UNIMOC-Universal-Motor-Control/hardware_4850/logic/datasheets/pas torque sensor.webp

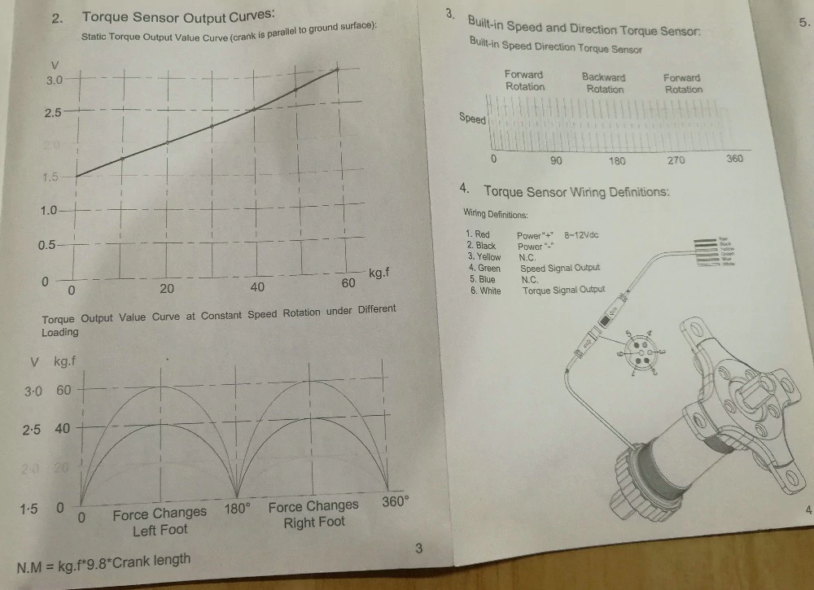
logic/datasheets/pas torque sensor.webp
