UNIMOC-Universal-Motor-Control/hardware_4850/logic/mcu_pinning.jpg

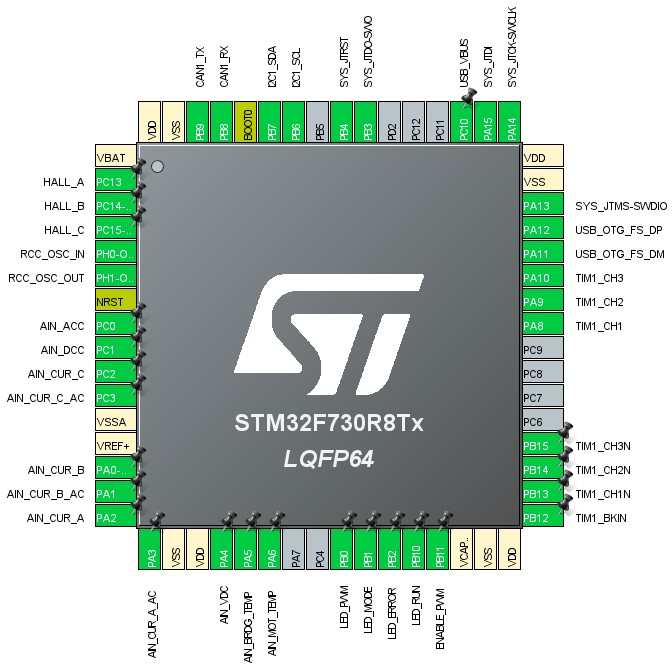
logic/mcu_pinning.jpg
