UNIMOC-Universal-Motor-Control/hardware_4850/README.md

# hardware_4850
48V at 50A with optimised colling
