UNIMOC-Universal-Motor-Control/hardware_4850/logic/sim/filter-design-current.pdf

## Filter Design Report

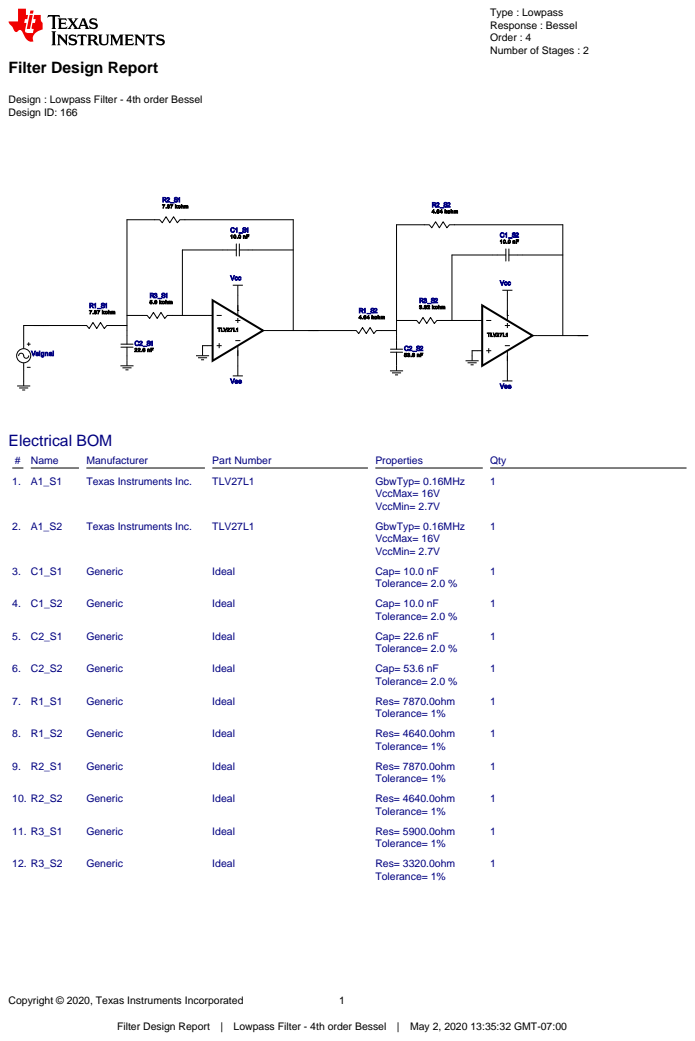
[picture p3: page 1]
Copyright © 2020, Texas Instruments Incorporated; Vsignal; TLV27L1; R1_S1 7.87 kohm; R2_S1 7.87 kohm; R3_S1 5.9 kohm; Vcc; Vee; R1_S2 4.64 kohm; R2_S2 4.64 kohm; R3_S2 3.32 kohm; Electrical BOM; # Name; Manufacturer; Part Number; Properties; Qty; Texas Instruments Inc.; GbwTyp= 0.16MHz; VccMax= 16V VccMin= 2.7V; Generic; Ideal; Cap= 10.0 nF; Tolerance= 2.0 %; Cap= 22.6 nF; Cap= 53.6 nF; Res= 7870.0ohm; Tolerance= 1%; Res= 4640.0ohm; Res= 5900.0ohm; Res= 3320.0ohm

Type : Lowpass
Response : Bessel
Order : 4
Number of Stages : 2

Design : Lowpass Filter - 4th order Bessel
Design ID: 166

Filter Design Report | Lowpass Filter - 4th order Bessel | May 2, 2020 13:35:32 GMT-07:00

## Sensitivity Analysis

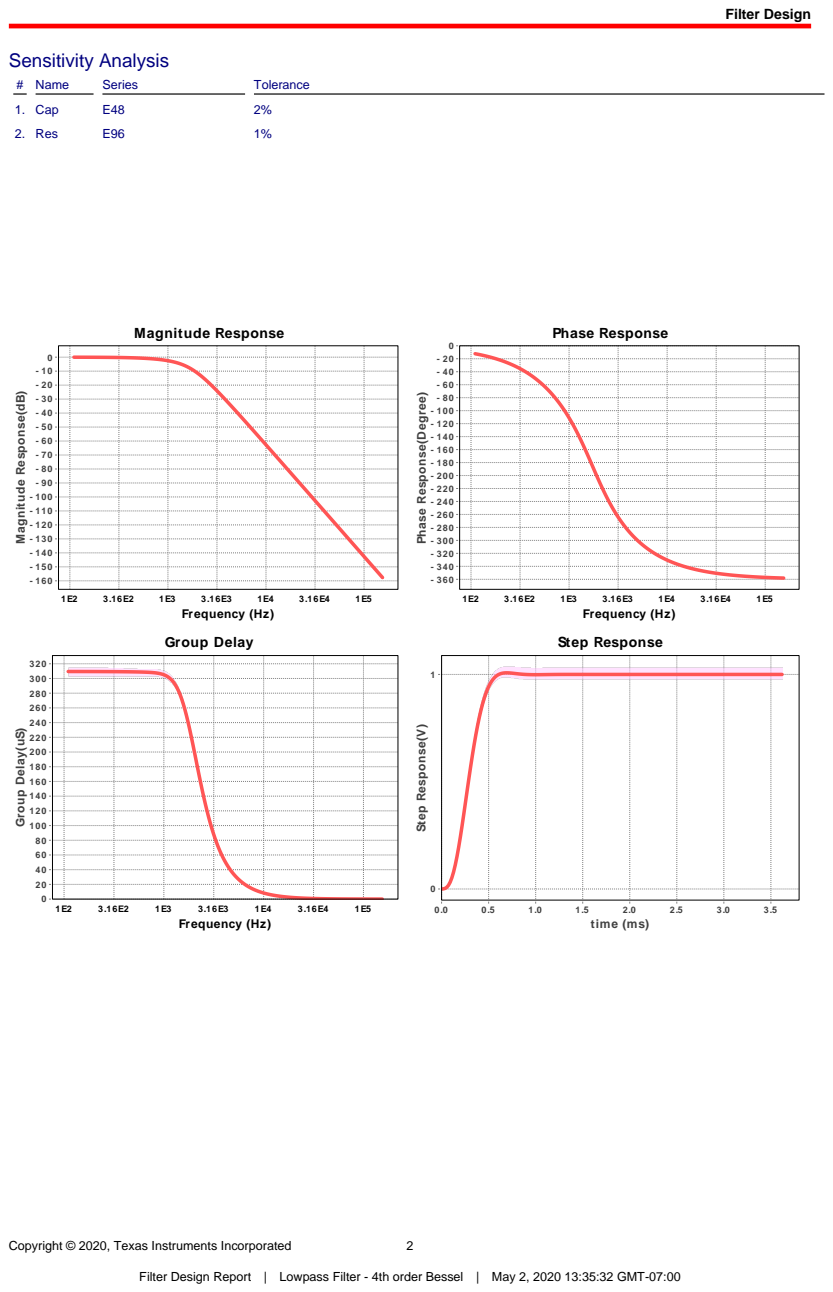
[picture p4: page 2]
Filter Design; # Name; Series; Tolerance; 1. Cap; 2. Res; Magnitude Response; 1E5 Frequency (Hz); Phase Response; Group Delay; Step Response; time (ms); 1Step Response⁽V⁾

Magnitude Response(dB)

Phase Response(Degree)

Group Delay(uS)

## Design Inputs

# | Name | Value | Description

1. FilterType | lowpass
2. FilterResponse | Bessel
3. FilterOrder | 4.0
4. FilterTopology | Multiple Feedback
5. NumberOfStages | 2.0
6. PassbandFrequency | 1.1 k
7. StopbandAttenuation | -78.912
8. StopbandFrequency | 16.0 k
9. Gain | 1.0
10. DualSupply | +/-5.00 V | Power supply(s) to active chips
11. ResistorTolerance | E96 | Resistor series - 1% Passive resistor tolerance
12. CapacitorTolerance | E48 | Capacitor series - 2% Passive capacitor tolerance

## Design Assistance

1. TLV27L1 Product Folder : http://www.ti.com/product/TLV27L1 : contains the data sheet and other resources.

# Filter Stage :1

Cutoff Frequency | 1.554 kHz
Min GBW Reqd | 81.482 kHz
Stage Gain | 1.0 V/V
Stage Q | 520.791 m
Stage Topology | Multiple Feedback
| R2_S1 7.87 kohm

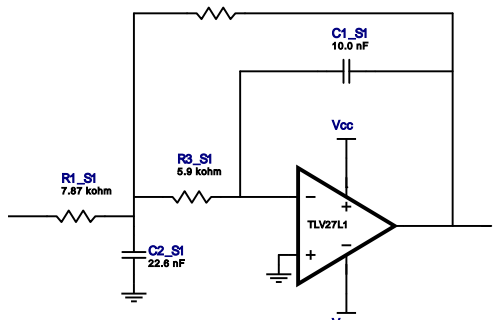
[picture p5: figure]
TLV27L1; R1_S1 7.87 kohm; R3_S1 5.9 kohm; Vcc

Vee

## Electrical BOM

# Name | Manufacturer | Part Number | Properties | Qty

1. A1_S1 | Texas Instruments Inc. | TLV27L1 | GbwTyp= 0.16MHz VccMax= 16V VccMin= 2.7V | 1
2. C1_S1 | Generic | Ideal | Cap= 10.0 nF Tolerance= 2.0 %

1

3. C2_S1 | Generic | Ideal | Cap= 22.6 nF Tolerance= 2.0 %

1

4. R1_S1 | Generic | Ideal | Res= 7870.0ohm Tolerance= 1%

1

5. R2_S1 | Generic | Ideal | Res= 7870.0ohm Tolerance= 1%

1

6. R3_S1 | Generic | Ideal | Res= 5900.0ohm Tolerance= 1%

1

# Filter Stage :2

Cutoff Frequency | 1.751 kHz
Min GBW Reqd | 140.997 kHz
Stage Gain | 1.0 V/V
Stage Q | 805.566 m
Stage Topology | Multiple Feedback
| R2_S2 4.64 kohm

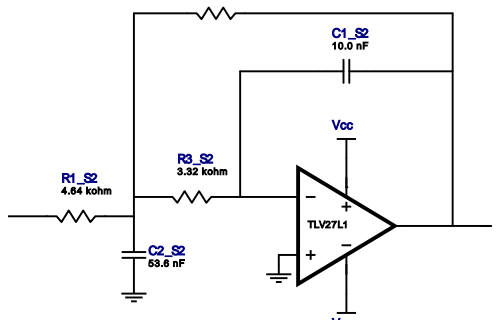
[picture p6: figure]
TLV27L1; R1_S2 4.64 kohm; R3_S2 3.32 kohm; Vcc

Vee

## Electrical BOM

# Name | Manufacturer | Part Number | Properties | Qty

1. A1_S2 | Texas Instruments Inc. | TLV27L1 | GbwTyp= 0.16MHz VccMax= 16V VccMin= 2.7V | 1
2. C1_S2 | Generic | Ideal | Cap= 10.0 nF Tolerance= 2.0 %

1

3. C2_S2 | Generic | Ideal | Cap= 53.6 nF Tolerance= 2.0 %

1

4. R1_S2 | Generic | Ideal | Res= 4640.0ohm Tolerance= 1%

1

5. R2_S2 | Generic | Ideal | Res= 4640.0ohm Tolerance= 1%

1

6. R3_S2 | Generic | Ideal | Res= 3320.0ohm Tolerance= 1%

1

Important Notice and Disclaimer

TI provides technical and reliability data (including datasheets), design resources (including reference designs), application or other design advice, web tools, safety information, and other resources AS IS and with all faults, and disclaims all warranties. These resources are intended for skilled developers designing with TI products. You are solely responsible for (1) selecting the appropriate TI products for your application, (2) designing, validating and testing your application, and (3) ensuring your application meets applicable standards, and any other safety, security, or other requirements.

These resources are subject to change without notice. TI grants you permission to use these resources only for development of an application that uses the TI products described in the resource. Other reproduction and display of these resources is prohibited. No license is granted to any other TI intellectual property right or to any third party intellectual property right. TI disclaims responsibility for, and you will fully indemnify TI and its representatives against, any claims, damages, costs, losses, and liabilities arising out of your use of these resources.

Providing these resources does not expand or otherwise alter TI's applicable Terms of Sale or other applicable terms available either on ti.com or provided in conjunction with TI products.
