UNIMOC-Universal-Motor-Control/hardware_4850/logic/sim/Multiple Feedback Low-pass Filter Design first stage current.pdf

### Multiple Feedback Filter

## Multiple Feedback Low-pass Filter Design Tool - Result -

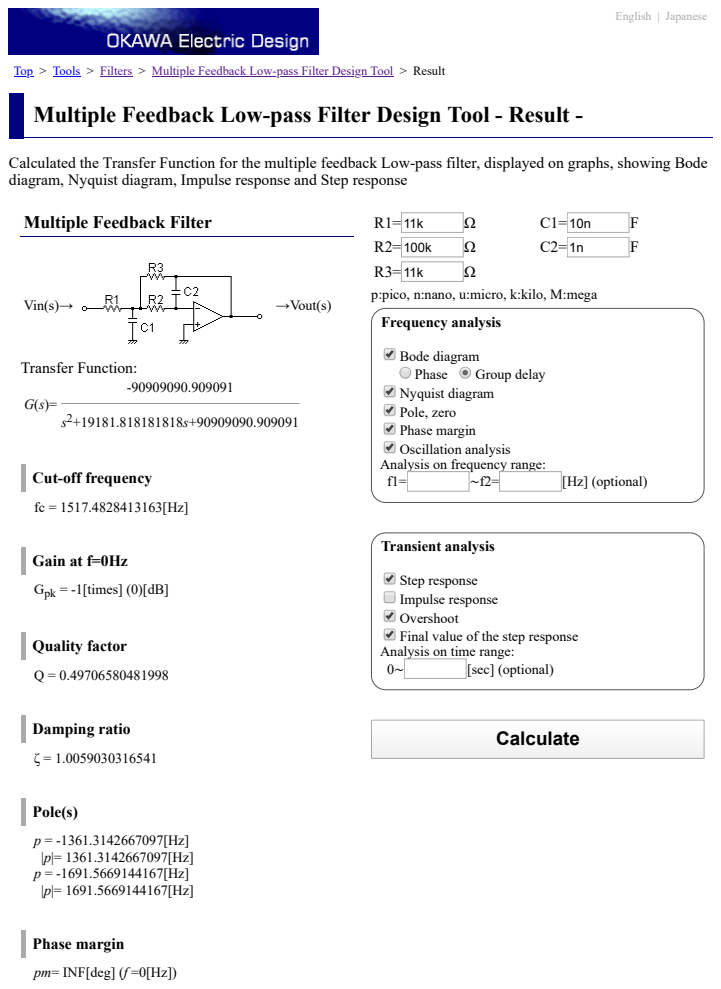
[picture p7: page 1]
Vin(s)→; →Vout(s); Transfer Function:; Gain at f=0Hz; Quality factor; Damping ratio; Pole(s); Phase margin; Phase; Group delay; [Hz] (optional); Transient analysis; [sec] (optional); Calculate; English | Japanese

Top (http://okawa-denshi.jp/) > Tools (http://sim.okawa-denshi.jp/en/) > Filters (http://sim.okawa-denshi.jp/en/Fkeisan.htm) > Multiple Feedback Low-pass Filter Design Tool (http://sim.okawa-denshi.jp/en/OPtazyuLowkeisan.htm) > Result

Calculated the Transfer Function for the multiple feedback Low-pass filter, displayed on graphs, showing Bode
diagram, Nyquist diagram, Impulse response and Step response

p:pico, n:nano, u:micro, k:kilo, M:mega
Frequency analysis

Bode diagram
Nyquist diagram
Pole, zero
Phase margin
Oscillation analysis
Analysis on frequency range:

Cut-off frequency

Gpk = -1[times] (0)[dB]

Step response
Impulse response
Overshoot
Final value of the step response
Analysis on time range:

pm= INF[deg] (f =0[Hz])

The system does not oscillate.

Overshoot (in absolute value)

The peak of transient waveform is not detected.

Final value of the step response (on the condition that the system converged when t goes to infinity)

g(∞) = -1

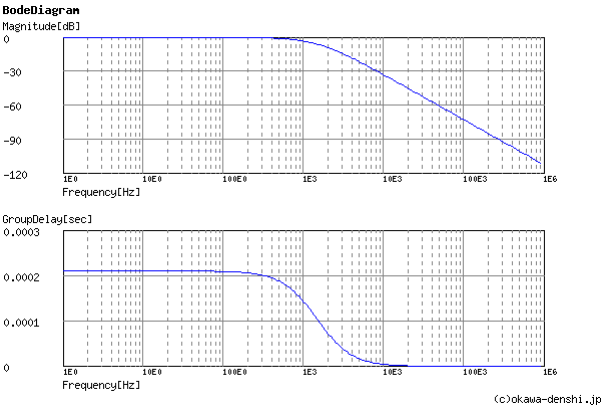
[picture p8: figure]

Gain characteristics at the Bode Diagram (http://sim.okawa-denshi.jp/en/im_grph.php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) (provides up to 1 minute)

Group delay characteristics (http://sim.okawa-denshi.jp/en/im_grph.php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) (provides up to 1 minute)

Bode Diagram text data (http://sim.okawa-denshi.jp/en/da/grd_24.txt) (provides up to 1 minute)

## Frequency analysis

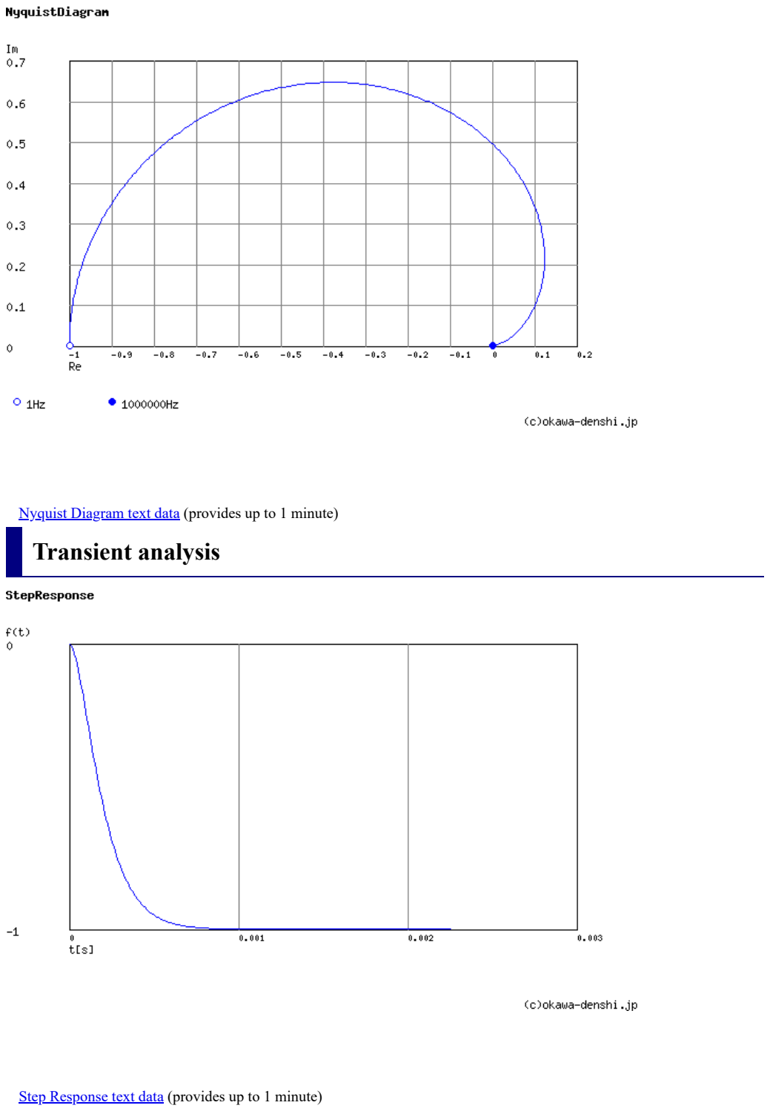
[picture p9: page 3]

Nyquist Diagram text data (http://sim.okawa-denshi.jp/en/da/grd2_376.txt) (provides up to 1 minute)

Step Response text data (http://sim.okawa-denshi.jp/en/da/grdtr_775.txt) (provides up to 1 minute)

## Transient analysis

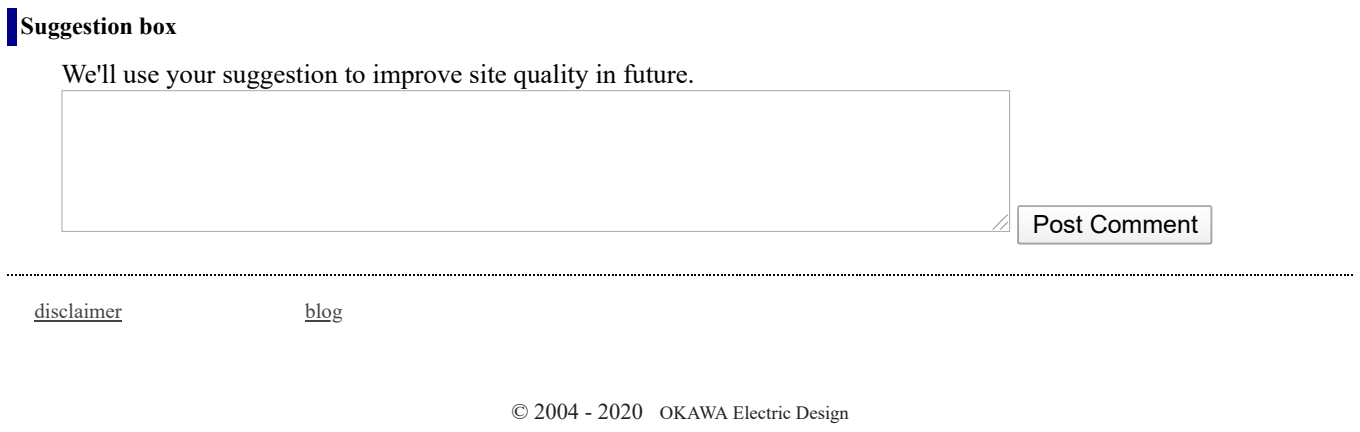
[picture p10: figure]
Suggestion box; Post Comment; disclaimer; blog; © 2004 - 2020 OKAWA Electric Design

We'll use your suggestion to improve site quality in future.
