UNIMOC-Universal-Motor-Control/hardware_4850/logic/power.png

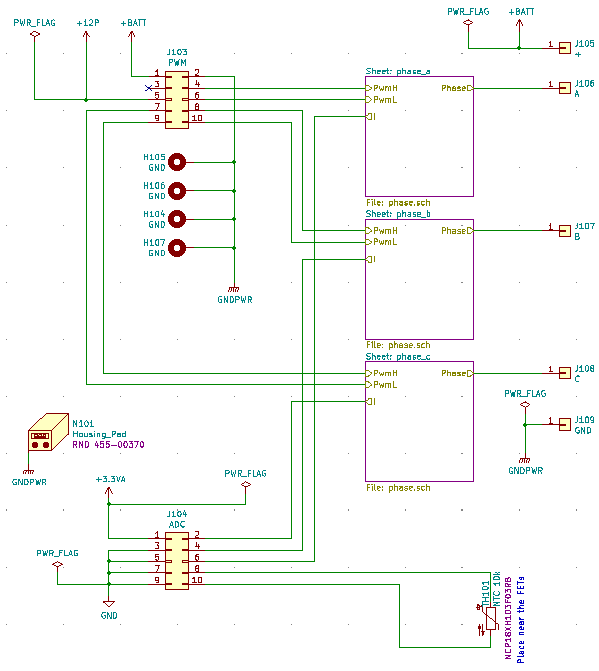
logic/power.png
