UNIMOC-Universal-Motor-Control/hardware_4850/logic/sim/highpass.png

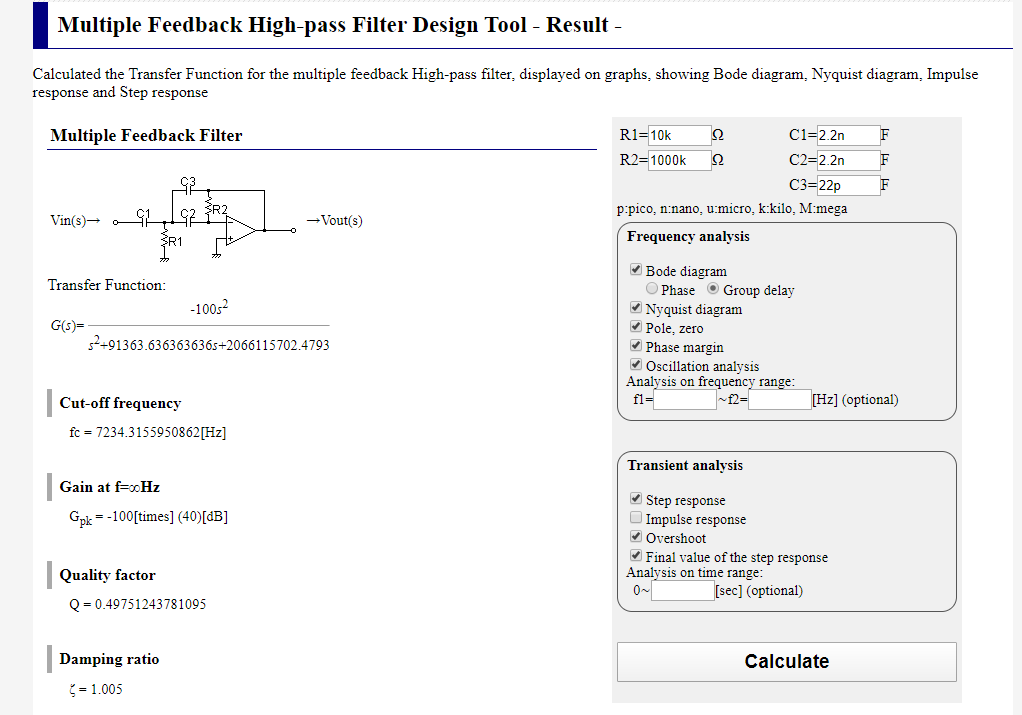
logic/sim/highpass.png
