UNIMOC-Universal-Motor-Control/hardware_4850/logic/sim/lowpass_2ord.png

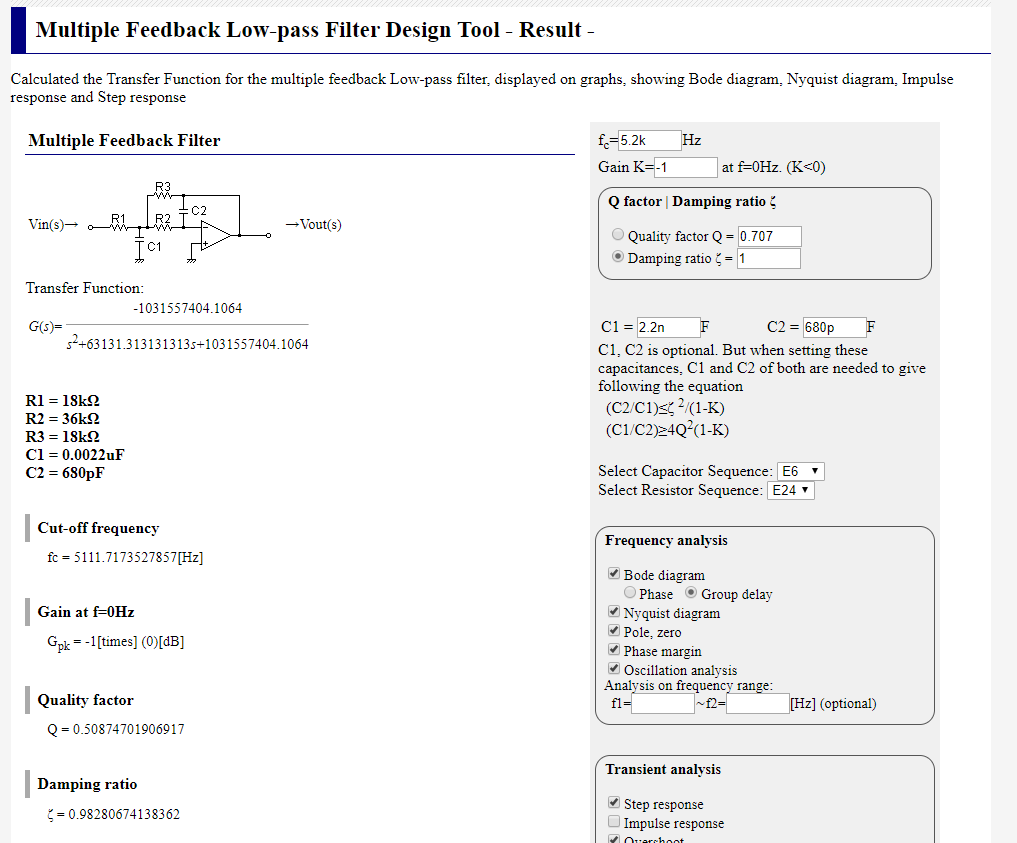
logic/sim/lowpass_2ord.png
