UNIMOC-Universal-Motor-Control/hardware_4850/power/logic.png

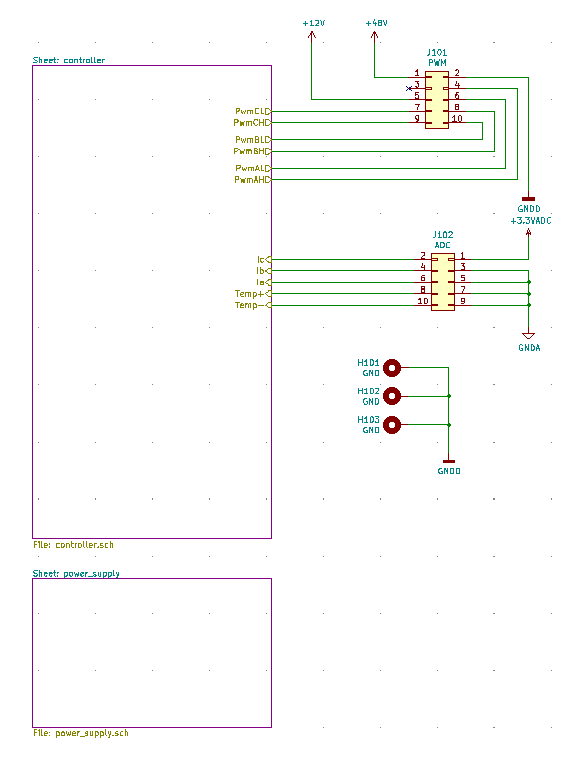
power/logic.png
