UNIMOC-Universal-Motor-Control/hardware_4850/BOM.xlsx

Reference | Quantity | Value | Footprint | Part# | Price per Part | Price
 | 1 | 10u | Capacitor_SMD:C_2220_5650Metric | FS55X106K101EHG | 0.29 € | 0.29 €
C505 C1107 C1106 | 3 | 1u | Capacitor_SMD:C_0603_1608Metric | CL10B105KANC | 0.03 € | 0.09 €
C506 C502 C503 C507 C610 C609 C608 C601 C611 C612 C605 C602 C604 C710 C701 C708 C707 C709 C711 C712 C810 C808 C807 C806 C910 C908 C907 C906 C1010 C1008 C1007 C1006 C1105 C1101 C1102 C1103 C1104 | 37 | 100n | Capacitor_SMD:C_0603_1608Metric | CL10B104KBNC | 0.02 € | 0.82 €
C508 C510 C504 C512 C511 | 5 | 22u | Capacitor_SMD:C_1210_3225Metric | CL32B226MOJNNNE | 0.28 € | 1.41 €
C509 | 1 | 2n2 | Capacitor_SMD:C_0603_1608Metric | GRM1885C1H222JA01D | 0.01 € | 0.01 €
C607 C606 C603 | 3 | 10u | Capacitor_SMD:C_1210_3225Metric | CL32B106KLJNNNE | 0.07 € | 0.21 €
C702 C704 C703 C804 C802 C801 C904 C902 C901 C1004 C1002 C1001 | 12 | 1n | Capacitor_SMD:C_0603_1608Metric | VJ0603Y102JXACW1BC | 0.05 € | 0.65 €
C706 C705 C803 C805 C903 C905 C1003 C1005 | 8 | 100p | Capacitor_SMD:C_0603_1608Metric | 0603B101K500CT | 0.002358 € | 0.02 €
C809 C909 C1009 | 3 | 10n | Capacitor_SMD:C_0603_1608Metric | 0603B102K101 | 0.002805 € | 0.01 €
D1101 | 1 | RUN | LED_SMD:LED_0603_1608Metric | 598-8070-107F | 0.09 € | 0.09 €
D1102 | 1 | ERROR | LED_SMD:LED_0603_1608Metric | 598-8070-107F | 0.09 € | 0.09 €
D1103 | 1 | FW | LED_SMD:LED_0603_1608Metric | 598-8070-107F | 0.09 € | 0.09 €
D1104 | 1 | PWM | LED_SMD:LED_0603_1608Metric | 598-8070-107F | 0.09 € | 0.09 €
D501 D505 | 2 | SS110R3G | Diode_SMD:D_SMA | SS110R3G | 0.02 € | 0.03 €
D502 D506 | 2 | PMLL4153 | Diode_SMD:D_MiniMELF | PMLL4153,115 | 0.01 € | 0.02 €
D503 | 1 | 3V3 | LED_SMD:LED_0603_1608Metric | 598-8070-107F | 0.09 € | 0.09 €
D504 | 1 | 12V | LED_SMD:LED_0603_1608Metric | 598-8070-107F | 0.09 € | 0.09 €
FB501 FB502 | 2 | Ferrite_Bead_Small | Resistor_SMD:R_0603_1608Metric | ACML-0603-2000 | 0.03 € | 0.05 €
J101 | 1 | PWM | Connector_PinHeader_2.54mm:PinHeader_2x05_P2.54mm_Vertical_SMD | C124391 | 0.04 € | 0.04 €
J102 | 1 | ADC | Connector_PinHeader_2.54mm:PinHeader_2x05_P2.54mm_Vertical_SMD | C124391 | 0.04 € | 0.04 €
J1101 | 1 | HALL | Connector_JST:JST_PH_S5B-PH-K_1x05_P2.00mm_Horizontal | C157923 | 0.05 € | 0.05 €
J1102 | 1 | PWM_EN | Connector_JST:JST_PH_S2B-PH-K_1x02_P2.00mm_Horizontal | C157929 | 0.02 € | 0.02 €
J1103 | 1 | CAN_IN | Connector_JST:JST_PH_S4B-PH-K_1x04_P2.00mm_Horizontal | C157926 | 0.03 € | 0.03 €
J1104 | 1 | CAN_Out | Connector_JST:JST_PH_S4B-PH-K_1x04_P2.00mm_Horizontal | C157926 | 0.03 € | 0.03 €
J501 | 1 | Enable | Connector_JST:JST_PH_S3B-PH-K_1x03_P2.00mm_Horizontal | C157929 | 0.02 € | 0.02 €
J601 | 1 | AIN | Connector_JST:JST_PH_S4B-PH-K_1x04_P2.00mm_Horizontal | C157926 | 0.03 € | 0.03 €
J602 | 1 | USB_B_Mini | Connector_USB:USB_Mini-B_Lumberg_2486_01_Horizontal | C69074 | 0.05 € | 0.05 €
J701 | 1 | MOT_TEMP | Connector_JST:JST_PH_S2B-PH-K_1x02_P2.00mm_Horizontal | C157929 | 0.02 € | 0.02 €
L501 | 1 | 4u7 | Inductor_SMD:L_1206_3216Metric | MIP25204R7MBE | 0.03 € | 0.03 €
L502 | 1 | 330u | Inductor_SMD:L_Taiyo-Yuden_NR-80xx_HandSoldering | SMNR8040-331MT | 0.08 € | 0.08 €
P1101 | 1 | SWD | Connector_PinHeader_1.27mm:PinHeader_2x05_P1.27mm_Vertical |  | 0.10 € | 0.10 €
R501 | 1 | 220k | Resistor_SMD:R_0603_1608Metric | CR0603JA0224G | 0.000606 € | 0.000606 €
R502 | 1 | 100k | Resistor_SMD:R_0603_1608Metric | CR0603-JW-104ELF | 0.00256 € | 0.00256 €
R503 R505 R601 R605 R602 R603 R708 R712 R713 R706 R710 R711 R808 R809 R806 R807 R804 R908 R909 R906 R907 R904 R1008 R1009 R1006 R1007 R1004 R1112 R1113 R1115 R1101 R1105 | 32 | 11k | Resistor_SMD:R_0603_1608Metric | MCR03ERTJ113 | 0.00256 € | 0.08 €
R504 | 1 | 34k | Resistor_SMD:R_0603_1608Metric | ERJ-PA3F3402V | 0.00256 € | 0.00256 €
R506 | 1 | 2k7 | Resistor_SMD:R_0603_1608Metric | RS-03K272JT | 0.00256 € | 0.00256 €
R507 R1104 R1103 R1102 R1106 R1107 R1110 R1111 | 8 | 510R | Resistor_SMD:R_0603_1608Metric | MCR03ERTJ511 | 0.00256 € | 0.02 €
R512 R511 R510 R509 R508 R1114 R1108 R1109 | 8 | 11R | Resistor_SMD:R_0603_1608Metric | MCR03ERTJ11R | 0.00256 € | 0.02 €
R513 | 1 | 910R | Resistor_SMD:R_0603_1608Metric | MCR03ERTJ911 | 0.00256 € | 0.00256 €
R604 R705 R709 R704 R707 R803 R801 R903 R901 R1003 R1001 | 11 | 4k7 | Resistor_SMD:R_0603_1608Metric | 0603WAJ0472T5E | 0.00256 € | 0.03 €
R609 R610 R611 R606 R607 R608 | 6 | 1R1 | Resistor_SMD:R_0603_1608Metric | MCR03ERTJ1R1 | 0.00256 € | 0.02 €
R702 | 1 | 560R 0.1% | Resistor_SMD:R_0603_1608Metric | AR03BTDX5600 | 0.02 € | 0.02 €
R703 R701 R716 | 3 | 10k 0.1% | Resistor_SMD:R_0603_1608Metric | ARG03BTC1002 | 0.02 € | 0.07 €
R715 R714 R811 R810 R911 R910 R1011 R1010 | 8 | 21R | Resistor_SMD:R_0603_1608Metric |  | 0.00256 € | 0.02 €
R802 R902 R1002 | 3 | 47k | Resistor_SMD:R_0603_1608Metric |  | 0.00256 € | 0.01 €
R805 R905 R1005 | 3 | 1M | Resistor_SMD:R_0603_1608Metric |  | 0.00256 € | 0.01 €
U1101 | 1 | TCAN334 | Package_TO_SOT_SMD:SOT-23-8 | TCAN334DCNR | 1.09 € | 1.09 €
U1102 | 1 | 24LC04 | Package_SO:SO-8_3.9x4.9mm_P1.27mm | AT34C04-SS5M-B | 0.11 € | 0.11 €
U1103 | 1 | AP2204K-5.0 | Package_TO_SOT_SMD:SOT-23-5 | AP2204K-5.0TRG1 | 0.09 € | 0.09 €
U501 | 1 | LMR12010Y | Package_TO_SOT_SMD:SOT-23-6 | LMR12010YMK/NOPB | 0.58 € | 0.58 €
U502 | 1 | LM5008 | Package_SO:MSOP-8_3x3mm_P0.65mm | LM5008MMX/NOPB | 0.76 € | 0.76 €
U601 | 1 | STM32F730R8Tx | Package_QFP:LQFP-64_10x10mm_P0.5mm | 511-STM32F730R8T6 | 4.46 € | 4.46 €
U701 U801 U901 U1001 | 4 | GS8632-MR | Package_SO:MSOP-8_3x3mm_P0.65mm | GS8632-MR | 0.09 € | 0.34 €
X601 | 1 | SM44T | Oscillator:Oscillator_SMD_Abracon_ASE-4Pin_3.2x2.5mm | SM4444TEV-20.0M | 1.40 € | 1.40 €
C202 C205 C302 C305 C402 C405 | 6 | 100n | Capacitor_SMD:C_0603_1608Metric | CL10B104KBNC | 0.04 € | 0.26 €
C203 C201 C303 C301 C403 C401 | 6 | 10u | Capacitor_SMD:C_1206_3216Metric | CC1206ZKY5V8BB106 | 0.04 € | 0.23 €
C204 C304 C404 | 3 | 10u | Capacitor_SMD:C_2220_5650Metric | FS55X106K101EHG | 0.30 € | 0.90 €
C207 C209 C307 C309 C407 C409 | 6 | 56u | Capacitor_SMD:CP_Elec_10x10 | GYA1J560MCQ1GS | 1.25 € | 7.53 €
D201 D301 D401 | 3 | SS110R3G | Diode_SMD:D_SMA | SS110R3G | 0.02 € | 0.05 €
J103 | 1 | PWM | Connector_PinSocket_2.54mm:PinSocket_2x05_P2.54mm_Vertical_SMD | C261072 | 0.07 € | 0.07 €
J104 | 1 | ADC | Connector_PinSocket_2.54mm:PinSocket_2x05_P2.54mm_Vertical_SMD | C261072 | 0.07 € | 0.07 €
N101 | 1 | Housing_Pad | hardware_4850:RND-455-00370 | RND 455-00370 | 7.50 € | 7.50 €
Q201 Q203 Q202 Q204 Q301 Q303 Q302 Q304 Q401 Q403 Q402 Q404 | 12 | NCEP6080AG | Package_TO_SOT_SMD:LFPAK56_ThermalVias-1 | 726-BSC040N08NS5ATMA | 1.46 € | 17.52 €
R201 R202 R211 R301 R302 R311 R401 R402 R411 | 9 | 2mR | Resistor_SMD:R_2512_6332Metric | MS122WF200NT4E | 0.07 € | 0.61 €
R203 R209 R207 R205 R206 R208 R204 R210 R303 R309 R307 R305 R306 R308 R304 R310 R403 R409 R407 R405 R406 R408 R404 R410 | 24 | 1R1 | Resistor_SMD:R_0603_1608Metric | MCR03ERTJ1R1 | 0.00256 € | 0.06 €
TH101 | 1 | NTC 10k | Resistor_SMD:R_0603_1608Metric | NCP18XH103F03RB | 0.03 € | 0.03 €
U201 U301 U401 | 3 | LM5109BMA | Package_SO:SOIC-8_3.9x4.9mm_P1.27mm | LM5109BMAX/NOPB | 0.33 € | 0.98 €
U202 U302 U402 | 3 | INA240A1PWR | Package_SO:TSSOP-8_4.4x3mm_P0.65mm | 595-INA240A2PWR | 1.39 € | 4.17 €
Sum |  |  |  |  |  | 53.82 €
