UNIMOC-Universal-Motor-Control/hardware_4850/logic/Warenkorb_Feb17_0727.xls

WARENKORB
Dies ist keine Rechnung
17-Feb-20 07:27:51
 | Mouser-Nr. | Herst.- Nr. | Hersteller | Kunden-Teilenr | Beschreibung | RoHS | Lebenszyklus | Stückzahl | Preis (EUR) | Gesamtpreis: (EUR)
1 | 603-RT0603BRD071ML | RT0603BRD071ML | Yageo |  | Dünnfilmwiderstände - SMD 1M OHM .1% 25PPM | RoHS: Konform durch Ausnahmegenehmigung |  | 100 | 0,063 € | 6,30 €
2 | 603-CC603FRNPO9BN220 | CC0603FRNPO9BN220 | Yageo |  | Kondensator aus mehreren Keramikschichten MLCC - SMD/SMT 22pF 50V NPO 1% | RoHS-konform |  | 100 | 0,041 € | 4,10 €
3 | 81-GCM1885C2A681FA6D | GCM1885C2A681FA16D | Murata |  | Kondensator aus mehreren Keramikschichten MLCC - SMD/SMT 0603 680pF 100volts C0G 1% | RoHS-konform |  | 100 | 0,087 € | 8,70 €
4 | 81-GRM1885C1H222FA1D | GRM1885C1H222FA01D | Murata |  | Kondensator aus mehreren Keramikschichten MLCC - SMD/SMT 2200PF 50V 1%0603 | RoHS-konform |  | 100 | 0,078 € | 7,80 €
5 | 603-RT0603BRD0718KL | RT0603BRD0718KL | Yageo |  | Dünnfilmwiderstände - SMD 18K ohm 0.1% 1/10W | RoHS: Konform durch Ausnahmegenehmigung |  | 100 | 0,068 € | 6,80 €
6 | 603-RT0603BRD0736KL | RT0603BRD0736KL | Yageo |  | Dünnfilmwiderstände - SMD 1/10W 36K ohm .1% 25ppm | RoHS: Konform durch Ausnahmegenehmigung |  | 100 | 0,068 € | 6,80 €
7 | 603-RT0603BRD0710KL | RT0603BRD0710KL | Yageo |  | Dünnfilmwiderstände - SMD 10K ohm 0.1% 1/10W | RoHS: Konform durch Ausnahmegenehmigung |  | 100 | 0,068 € | 6,80 €
Durch das Absenden Ihrer Bestellung erklären Sie sich mit diesen Geschäftsbedingungen einverstanden. (https://www.mouser.de/saleterms) |  |  |  |  |  |  |  |  | Gesamtwarenkosten: | 47,30 €
Die Preise sind zum angezeigten Datum und zur Uhrzeit reflektiert. |  |  |  |  |  |  |  |  | Versandkosten: | 20,00 €
