UNIMOC-Universal-Motor-Control/hardware_4850/KühlerUNIMOC10mmAlu.dxf

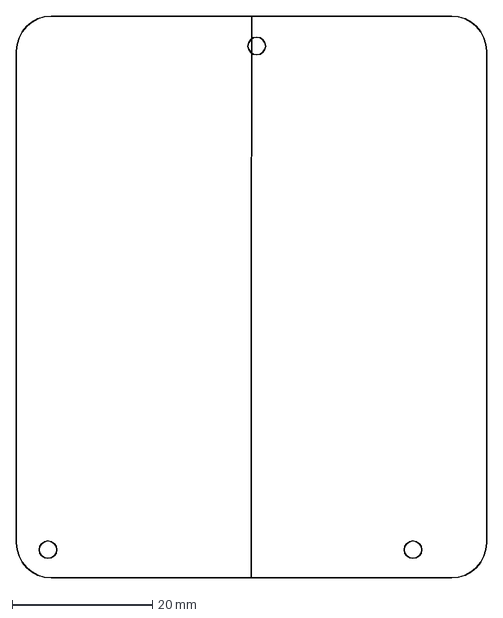
[picture p15: CAD file, 2020-10-09]
KühlerUNIMOC10mmAlu.dxf
67.0 x 80.0 mm
