UNIMOC-Universal-Motor-Control/hardware_4850/logic/footprints/enclosure_rnd_455-00370 v1.step

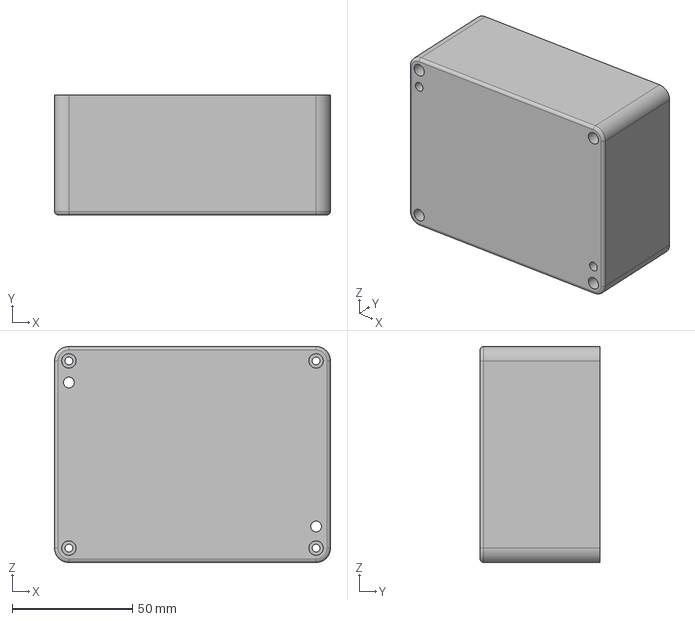
[picture p16: CAD file, 2019-11-02]
logic/footprints/enclosure_rnd_455-00370 v1.step
115.0 x 50.0 x 90.0 mm
