UNIMOC-Universal-Motor-Control/hardware_4850/power/footprints/enclosure_rnd_455-00370_front.dxf

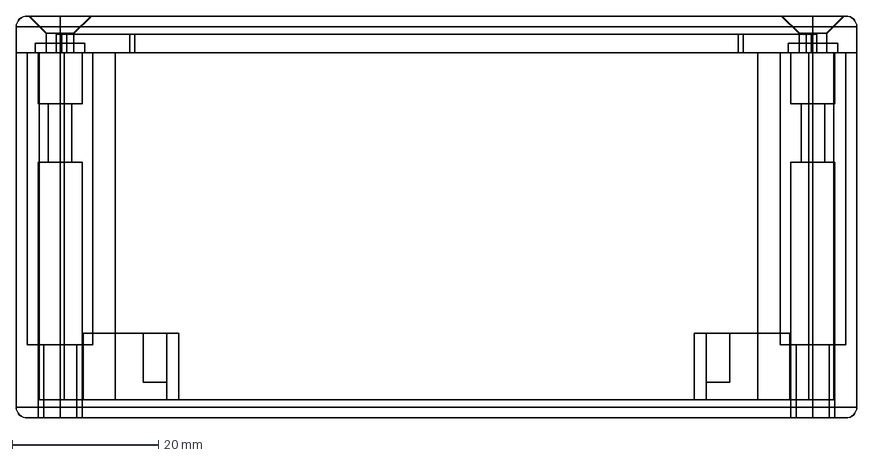
[picture p17: CAD file, 2019-11-02]
power/footprints/enclosure_rnd_455-00370_front.dxf
115.0 x 55.0 mm
