UNIMOC-Universal-Motor-Control/hardware_4850/power/hardware_4850-Top.dxf

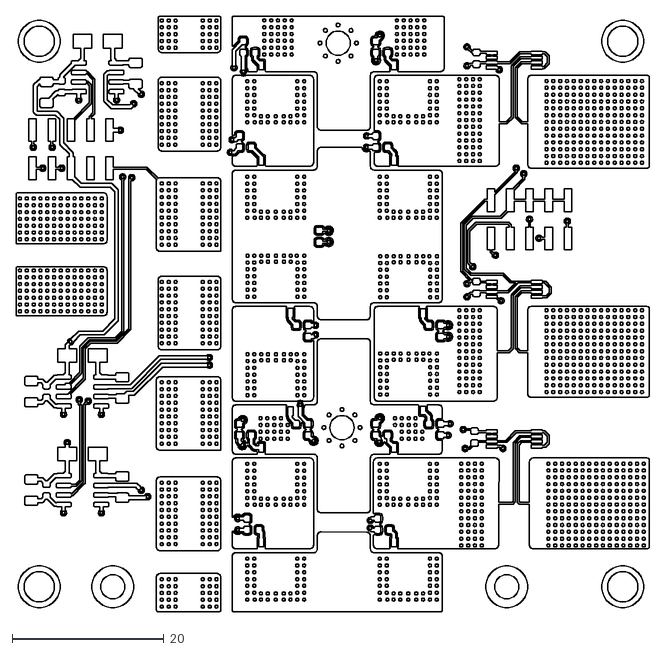
[picture p18: CAD file, 2020-10-09]
power/hardware_4850-Top.dxf
83.6 x 78.6
