UNIMOC-Universal-Motor-Control/hardware_4850/logic/footprints/enclosure_rnd_455-00370_right.dxf

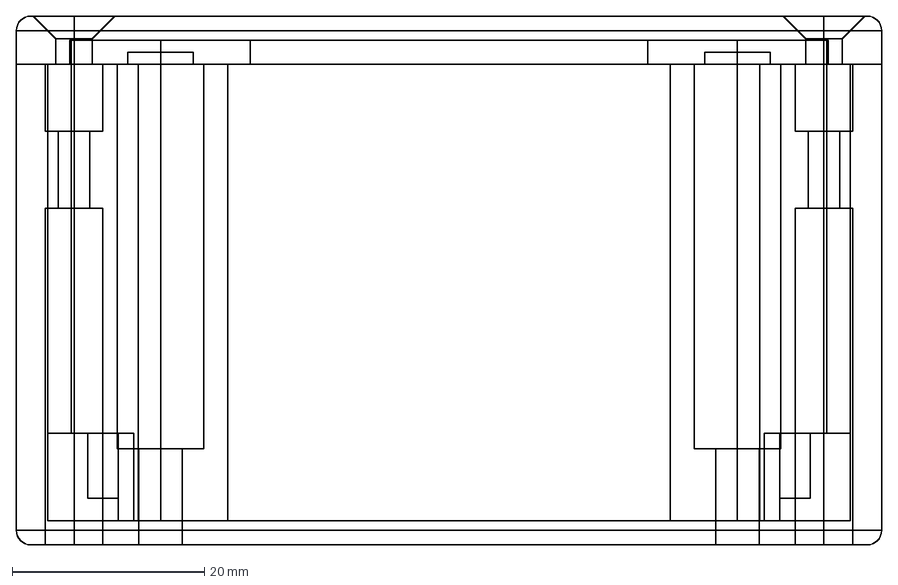
[picture p19: CAD file, 2019-11-02]
logic/footprints/enclosure_rnd_455-00370_right.dxf
90.0 x 55.0 mm
