UNIMOC-Universal-Motor-Control/hardware_4850/power/footprints/enclosure_rnd_455-00370.stp

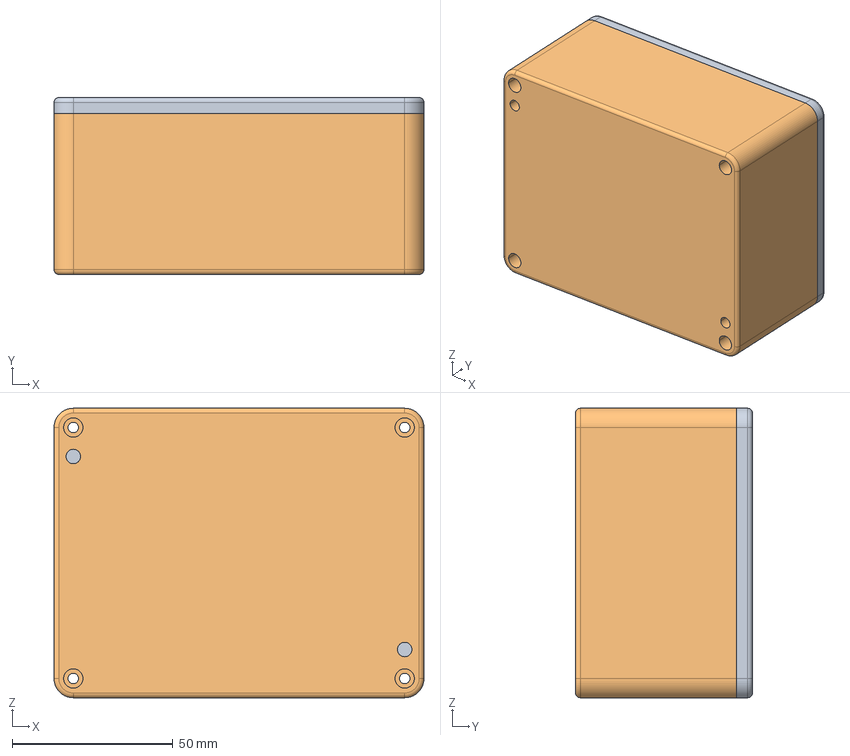
[picture p20: CAD file, 2019-11-02]
power/footprints/enclosure_rnd_455-00370.stp
115.0 x 55.0 x 90.0 mm
