UNIMOC-Universal-Motor-Control/hardware_4850/power/hardware_4850-Edge_Cuts.dxf

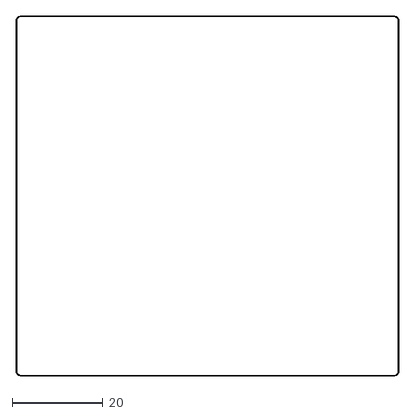
[picture p21: CAD file, 2020-10-09]
power/hardware_4850-Edge_Cuts.dxf
84.1 x 79.1
