UNIMOC-Universal-Motor-Control/hardware_4850/logic/footprints/enclosure_rnd_455-00370_back.dxf

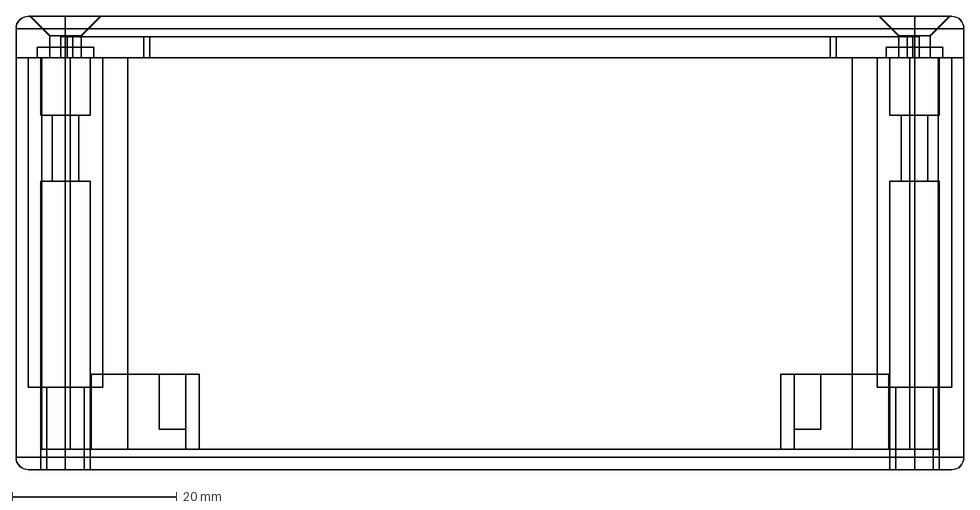
[picture p22: CAD file, 2019-11-02]
logic/footprints/enclosure_rnd_455-00370_back.dxf
115.0 x 55.0 mm
