UNIMOC-Universal-Motor-Control/hardware_4850/power/hardware_4850-Dwgs_User.dxf

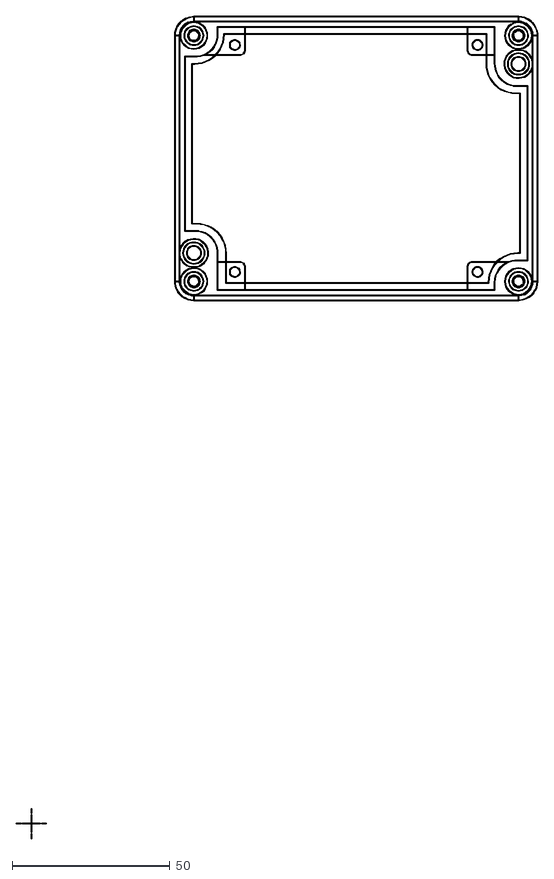
[picture p23: CAD file, 2020-10-09]
power/hardware_4850-Dwgs_User.dxf
165.4 x 260.8
