UNIMOC-Universal-Motor-Control/hardware_4850/power/footprints/enclosure_rnd_455-00370_left.dxf

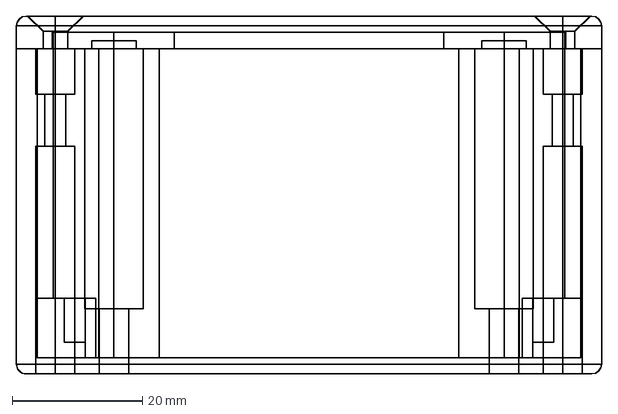
[picture p24: CAD file, 2019-11-02]
power/footprints/enclosure_rnd_455-00370_left.dxf
90.0 x 55.0 mm
