UNIMOC-Universal-Motor-Control/hardware_4850/power/footprints/enclosure_rnd_455-00370_bottom.dxf

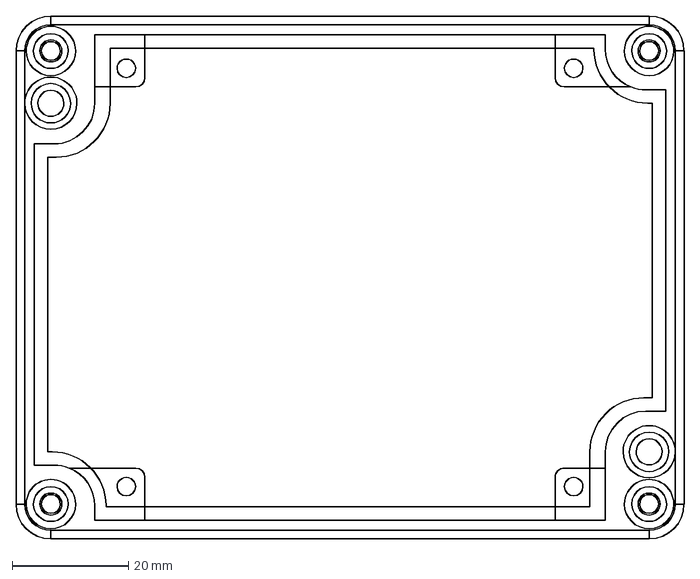
[picture p25: CAD file, 2019-11-02]
power/footprints/enclosure_rnd_455-00370_bottom.dxf
115.0 x 90.0 mm
