UNIMOC-Universal-Motor-Control/hardware_4850/logic/footprints/CSS4J-4026.stp

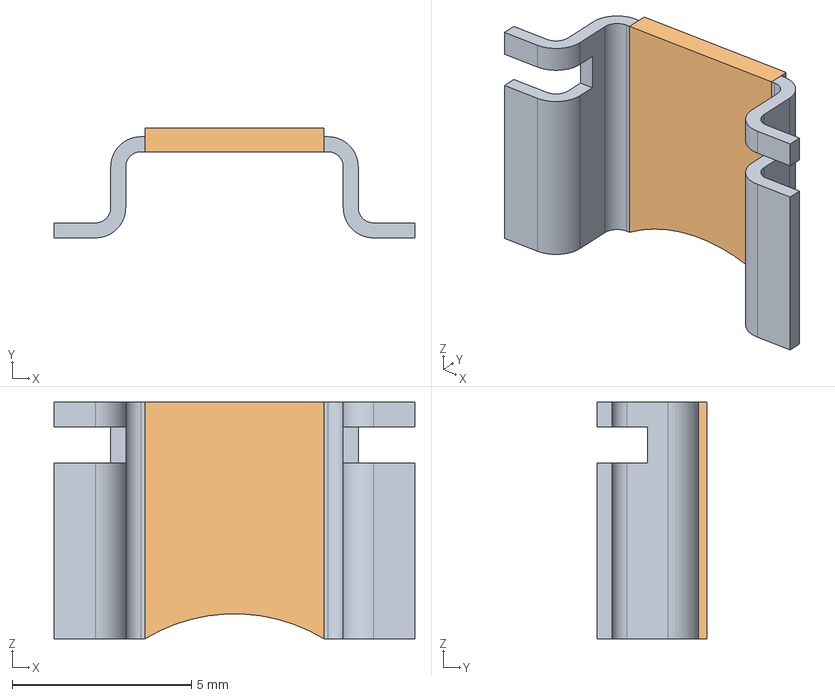
[picture p26: CAD file, 2019-11-02]
logic/footprints/CSS4J-4026.stp
10.1 x 3.06 x 6.60 mm
MANIFOLD_SOLID_BREP_694
MANIFOLD_SOLID_BREP_1384
RESISTENCE2_1
