UNIMOC-Universal-Motor-Control/hardware_4850/logic/footprints/enclosure_rnd_455-00370_iso.dxf

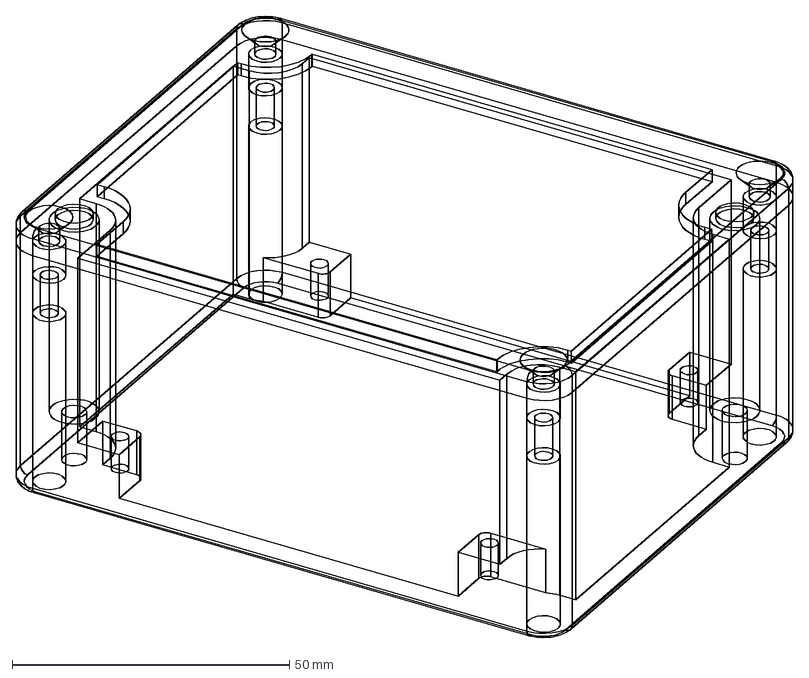
[picture p27: CAD file, 2019-11-02]
logic/footprints/enclosure_rnd_455-00370_iso.dxf
140.2 x 112.1 mm
