UNIMOC-Universal-Motor-Control/hardware_4850/power/footprints/enclosure_rnd_455-00370_top.dxf

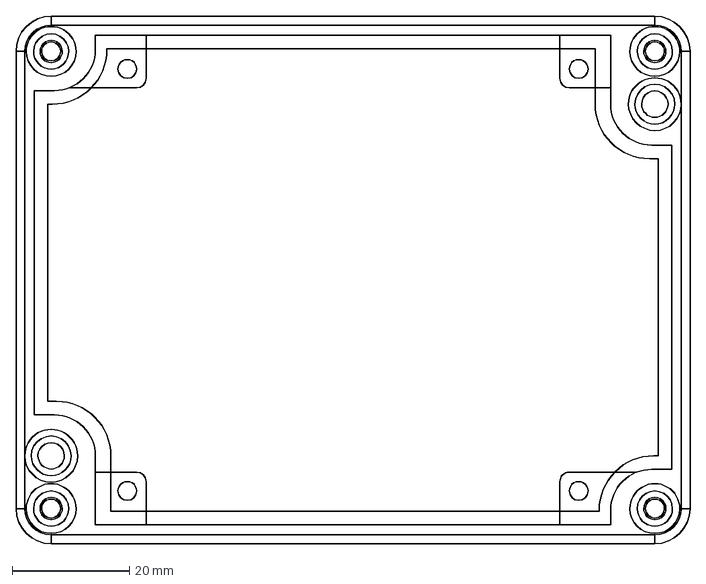
[picture p28: CAD file, 2019-11-02]
power/footprints/enclosure_rnd_455-00370_top.dxf
115.0 x 90.0 mm
