UNIMOC-Universal-Motor-Control/hardware_4850/(threads)

Thread 5 (2021-05-19):

simulation: spice modell fehlt

Virtex7, 2021-05-19:
for the simulation "current_filters.asc" the symbol for the ACS72981 is missing.
