UNIMOC-Universal-Motor-Control/hardware_4850/logic/sim/current_filters.asc

C1: cap; 4n7
C2: cap; 47p
C3: cap; 4n7
C4: cap; 100p
C5: cap; 47p
C6: cap; 4n7
C8: cap; 100n
R1: res; 4k7
R2: res; 910k
R3: res; 11k
R4: res; 11k
R5: res; 21
R6: res; 9k1
R7: res; 470k
R8: res; 11k
R9: res; 11k
R10: res; 21
R11: res; 9k1
U1: ADA4891
U4: ADA4891
V1: voltage; SINE(1.65 1.5 250); AC 1 0
V2: voltage; PULSE(-0.005 0.005 0 1u 24u 0 25u)
V3: voltage; 3.3
Named nets: 0, AC_CURRENT, DC_CURRENT
.tran 0 0.0203 0.02
