UNIMOC-Universal-Motor-Control/hardware_4850/power/hardware_4850.kicad_pcb

## KiCad design power/hardware_4850.kicad_pcb (2021-02-04)

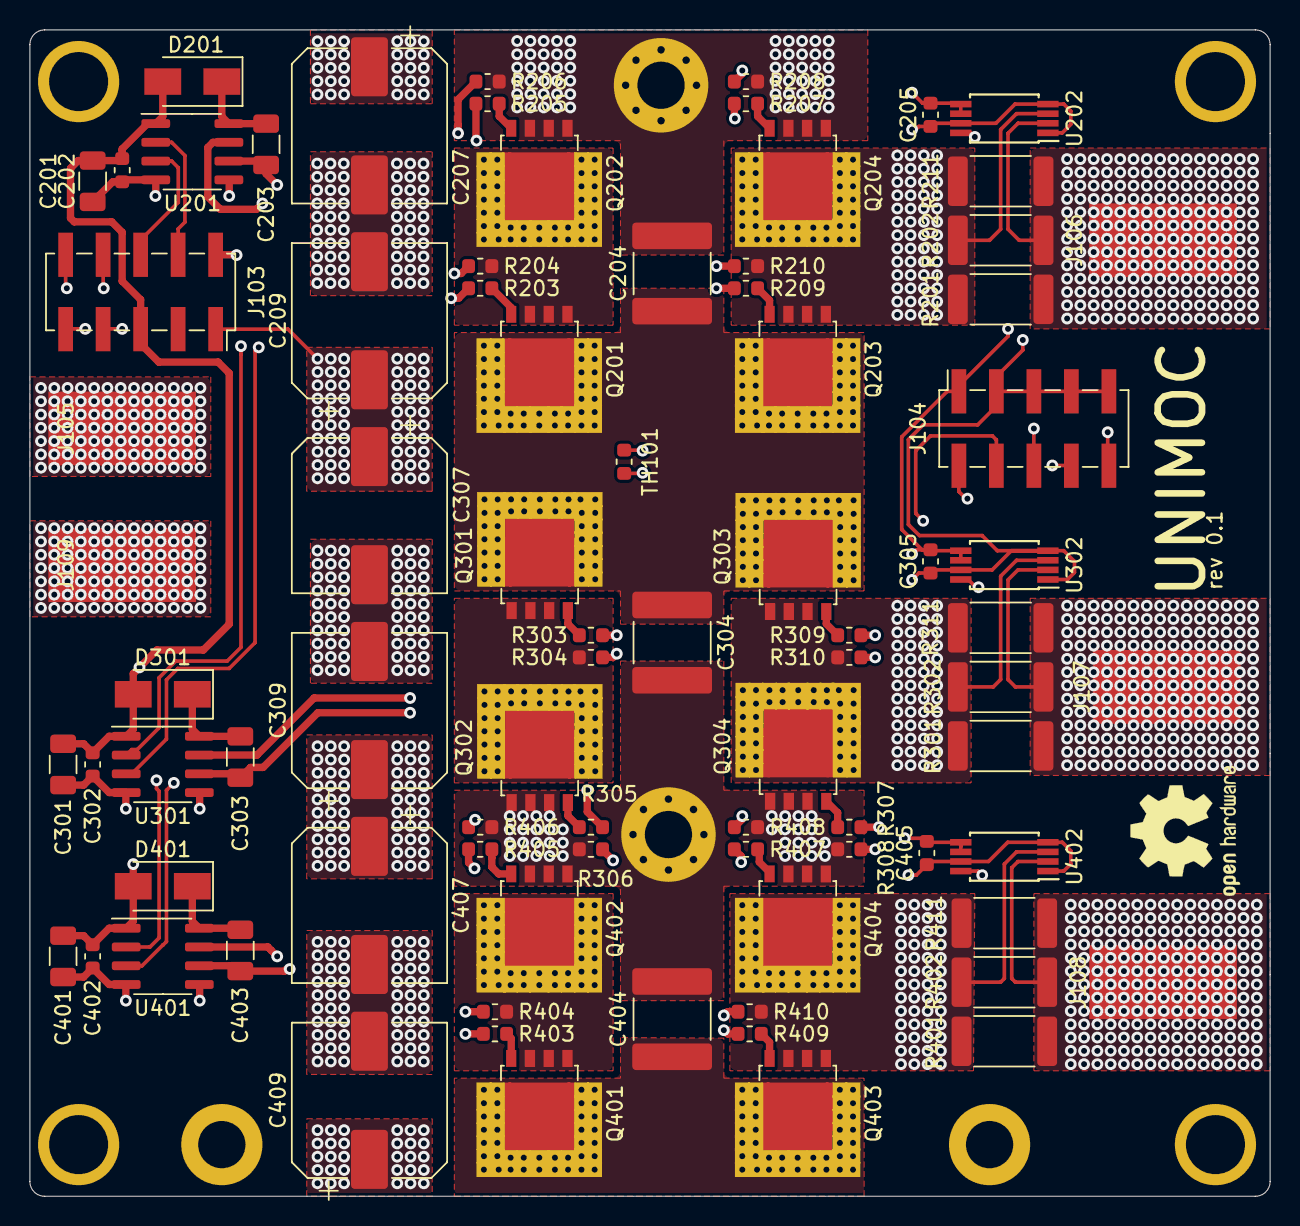
[picture p30: board power/hardware_4850.kicad_pcb from above]

Board: 4 copper layers, 84.0 x 79.0 mm, 88 parts (0 on the bottom side), 49 nets.

Parts:
C201, C203, C301, C303, C401, C403: 10u; C_1206_3216Metric
C202, C205, C302, C305, C402, C405: 100n; C_0603_1608Metric
C204, C304, C404: 10u; C_2220_5650Metric
C207, C209, C307, C309, C407, C409: 56u; CP_Elec_10x10
D201, D301, D401: SS110R3G; D_SMA
H104, H107: GND; MountingHole_3.2mm_M3_ISO14580_Pad
H105, H106: GND; MountingHole_3.2mm_M3_Pad_Via
J103: PWM; PinSocket_2x05_P2.54mm_Vertical_SMD
J104: ADC; PinSocket_2x05_P2.54mm_Vertical_SMD
J105: +; SolderWirePad_1x01_SMD_5x10mm
J106: A; SolderWirePad_1x01_SMD_5x10mm
J107: B; SolderWirePad_1x01_SMD_5x10mm
J108: C; SolderWirePad_1x01_SMD_5x10mm
J109: GND; SolderWirePad_1x01_SMD_5x10mm
N101: Housing_Pad; RND-455-00370
Q201, Q202, Q203, Q204, Q301, Q302, Q303, Q304, Q401, Q402, Q403, Q404: NCEP6080AG; LFPAK56_ThermalVias-1
R201, R202, R211, R301, R302, R311, R401, R402, R411: 2mR; R_2512_6332Metric
R203, R204, R205, R206, R207, R208, R209, R210, R303, R304, R305, R306, R307, R308, R309, R310, R403, R404, R405, R406, R407, R408, R409, R410: 1R1; R_0603_1608Metric
TH101: NTC 10k; R_0603_1608Metric
U201, U301, U401: LM5109BMA; SOIC-8_3.9x4.9mm_P1.27mm
U202, U302, U402: INA240A1PWR; TSSOP-8_4.4x3mm_P0.65mm

Connections:
+3.3VA: C205.1, C305.1, C405.1, J104.1, U202.5, U202.6, U302.5, U302.6, U402.5, U402.6
+12P: C201.1, C202.1, C301.1, C302.1, C401.1, C402.1, D201.2, D301.2, D401.2, J103.5, U201.1, U301.1, U401.1
+BATT: C204.1, C207.1, C209.1, C304.1, C307.1, C309.1, C404.1, C407.1, C409.1, J103.1, J105.1, Q201.5, Q203.5, Q301.5, Q303.5, Q401.5, Q403.5
/phase_a/I: J104.6, U202.8
/phase_a/Phase: J106.1, R201.1, R202.1, R211.1, U202.2
/phase_a/PwmH: J103.4, U201.2
/phase_a/PwmL: J103.6, U201.3
/phase_b/I: J104.4, U302.8
/phase_b/Phase: J107.1, R301.1, R302.1, R311.1, U302.2
/phase_b/PwmH: J103.8, U301.2
/phase_b/PwmL: J103.10, U301.3
/phase_c/I: J104.2, U402.8
/phase_c/Phase: J108.1, R401.1, R402.1, R411.1, U402.2
/phase_c/PwmH: J103.9, U401.2
/phase_c/PwmL: J103.7, U401.3
GND: C205.2, C305.2, C405.2, J104.3, J104.5, J104.7, J104.9, U202.1, U202.4, U202.7, U302.1, U302.4, U302.7, U402.1, U402.4, U402.7
GNDPWR: C204.2, C207.2, C209.2, C304.2, C307.2, C309.2, C404.2, C407.2, C409.2, H104.1, H105.1, H106.1, H107.1, J103.2, J109.1, N101.1, Q202.1, Q202.2, Q202.3, Q204.1, Q204.2, Q204.3, Q302.1, Q302.2, Q302.3, Q304.1, Q304.2, Q304.3, Q402.1, Q402.2, Q402.3, Q404.1, Q404.2, Q404.3, R206.1, R208.1, R306.1, R308.1, R406.1, R408.1
unnamed: C201.2, C202.2, R206.2, R208.2, U201.4
unnamed: C203.1, D201.1, U201.8
unnamed: C203.2, R204.2, R210.2, U201.6
unnamed: C301.2, C302.2, R306.2, R308.2, U301.4
unnamed: C303.1, D301.1, U301.8
unnamed: C303.2, R304.2, R310.2, U301.6
unnamed: C401.2, C402.2, R406.2, R408.2, U401.4
unnamed: C403.1, D401.1, U401.8
unnamed: C403.2, R404.2, R410.2, U401.6
unnamed: J104.8, TH101.1
unnamed: J104.10, TH101.2
unnamed: Q201.1, Q201.2, Q201.3, Q202.5, Q203.1, Q203.2, Q203.3, Q204.5, R201.2, R202.2, R204.1, R210.1, R211.2, U202.3
unnamed: Q201.4, R203.1
unnamed: Q202.4, R205.1
unnamed: Q203.4, R209.1
unnamed: Q204.4, R207.1
unnamed: Q301.1, Q301.2, Q301.3, Q302.5, Q303.1, Q303.2, Q303.3, Q304.5, R301.2, R302.2, R304.1, R310.1, R311.2, U302.3
unnamed: Q301.4, R303.1
unnamed: Q302.4, R305.1
unnamed: Q303.4, R309.1
unnamed: Q304.4, R307.1
unnamed: Q401.1, Q401.2, Q401.3, Q402.5, Q403.1, Q403.2, Q403.3, Q404.5, R401.2, R402.2, R404.1, R410.1, R411.2, U402.3
unnamed: Q401.4, R403.1
unnamed: Q402.4, R405.1
unnamed: Q403.4, R409.1
unnamed: Q404.4, R407.1
unnamed: R203.2, R209.2, U201.7
unnamed: R205.2, R207.2, U201.5
unnamed: R303.2, R309.2, U301.7
unnamed: R305.2, R307.2, U301.5
unnamed: R403.2, R409.2, U401.7
unnamed: R405.2, R407.2, U401.5
