UNIMOC-Universal-Motor-Control/hardware_4850/logic/pinning/unimoc_hardware_4850_pinning.ioc

Mcu.UserName=STM32F730R8Tx
PA0-WKUP.GPIO_Label=AIN_CUR_B
PA0-WKUP.Signal=ADCx_IN0
PA1.GPIO_Label=AIN_CUR_B_AC
PA1.Signal=ADCx_IN1
PA10.Signal=S_TIM1_CH3
PA11.Signal=USB_OTG_FS_DM
PA12.Signal=USB_OTG_FS_DP
PA13.Signal=SYS_JTMS-SWDIO
PA14.Signal=SYS_JTCK-SWCLK
PA15.Signal=SYS_JTDI
PA2.GPIO_Label=AIN_CUR_A
PA2.Signal=ADCx_IN2
PA3.GPIO_Label=AIN_CUR_A_AC
PA3.Signal=ADCx_IN3
PA4.GPIO_Label=AIN_VDC
PA4.Signal=ADCx_IN4
PA5.GPIO_Label=AIN_BRDG_TEMP
PA5.Signal=ADCx_IN5
PA6.GPIO_Label=AIN_MOT_TEMP
PA6.Signal=ADCx_IN6
PA8.Signal=S_TIM1_CH1
PA9.Signal=S_TIM1_CH2
PB0.GPIO_Label=LED_PWM
PB0.Signal=GPIO_Output
PB1.GPIO_Label=LED_MODE
PB1.Signal=GPIO_Output
PB10.GPIO_Label=LED_RUN
PB10.Signal=GPIO_Output
PB11.GPIO_Label=ENABLE_PWM
PB11.Signal=GPIO_Output
PB12.Signal=TIM1_BKIN
PB13.Signal=TIM1_CH1N
PB14.Signal=TIM1_CH2N
PB15.Signal=TIM1_CH3N
PB2.GPIO_Label=LED_ERROR
PB2.Signal=GPIO_Output
PB3.Signal=SYS_JTDO-SWO
PB4.Signal=SYS_JTRST
PB6.Signal=I2C1_SCL
PB7.Signal=I2C1_SDA
PB8.Signal=CAN1_RX
PB9.Signal=CAN1_TX
PC0.GPIO_Label=AIN_ACC
PC0.Signal=ADCx_IN10
PC1.GPIO_Label=AIN_DCC
PC1.Signal=ADCx_IN11
PC10.GPIO_Label=USB_VBUS
PC10.Signal=GPIO_Input
PC13.GPIO_Label=HALL_A
PC13.Signal=GPIO_Input
PC14-OSC32_IN.GPIO_Label=HALL_B
PC14-OSC32_IN.Signal=GPIO_Input
PC15-OSC32_OUT.GPIO_Label=HALL_C
PC15-OSC32_OUT.Signal=GPIO_Input
PC2.GPIO_Label=AIN_CUR_C
PC2.Signal=ADCx_IN12
PC3.GPIO_Label=AIN_CUR_C_AC
PC3.Signal=ADCx_IN13
PH0-OSC_IN.Signal=RCC_OSC_IN
PH1-OSC_OUT.Signal=RCC_OSC_OUT
