UNIMOC-Universal-Motor-Control/hardware_4850/(commit log)

2019-10-25 added simulation for current filters
2019-10-25 added kicad project
    added schematics for other projects as basis.
    [analog.sch, controller.sch, hardware_4850.kicad_pcb, hardware_4850.sch, interfaces.sch, phase.sch, power_supply.sch]
2019-10-25 removed useless parts
    [analog.sch, hardware_4850.sch]
2019-10-25 updated components
    - changed shunt to 1mR variant
    - changed Fet Driver to TI type
    - changed DC Link caps.
    [CSS4J-4026.stp, analog.sch, controller.sch, hardware_4850.sch, interfaces.sch, phase.sch, power_supply.sch]
2019-10-26 added mcu pinning
    [controller.sch, hardware_4850.sch, interfaces.sch, phase.sch]
2019-10-26 finished Rev0 of schematics
    [analog.sch, controller.sch, current_filters.sch, hardware_4850.kicad_pcb, hardware_4850.sch, interfaces.sch, phase.sch, power_supply.sch]
2019-10-28 added enclosure
    - first placing of power stage finished
    [analog.sch, controller.sch, enclosure_rnd_455-00370 v1.step, enclosure_rnd_455-00370.stp, enclosure_rnd_455-00370_back.dxf, enclosure_rnd_455-00370_bottom.dxf, enclosure_rnd_455-00370_front.dxf, enclosure_rnd_455-00370_iso.dxf]
2019-10-29 started placing of logic board
    [hardware_4850.kicad_pcb, phase.sch, power_supply.sch]
2019-11-01 more logic placing, switched halls for better routing
    [analog.sch, controller.sch, current_filters.sch, hardware_4850.kicad_pcb, hardware_4850.sch]
2019-11-02 finished placing :)
    [analog.sch, controller.sch, current_filters.sch, hardware_4850.kicad_pcb, hardware_4850.sch, interfaces.sch]
2019-11-07 changed shunts to standard footprint for more alternatives
    [hardware_4850.kicad_pcb, interfaces.sch, phase.sch, power_supply.sch]
2019-11-08 started routing of power stage
    [hardware_4850.kicad_pcb, phase.sch]
2019-11-09 finished power stage routing
    [hardware_4850.kicad_pcb, hardware_4850.sch]
2019-11-09 routing of logic supply finished
    [hardware_4850.kicad_pcb]
2019-11-09 started routing of logic board
    [hardware_4850.kicad_pcb]
2019-11-10 added monting holes for coolplate
    [hardware_4850.kicad_pcb, hardware_4850.sch, phase.sch]
2019-11-12 routed someof the analog systems
    [hardware_4850.kicad_pcb]
2019-11-16 changed design rules or logic board to smaller wires
    [hardware_4850.kicad_pcb]
2019-11-16 finished routing of logic pcb
    [hardware_4850.kicad_pcb]
2019-11-17 made 3d design for mounting in enclosure
    [hardware_4850.kicad_pcb, hardware_4850.sch, hardware_4850_logic.kicad_pcb, hardware_4850_power.kicad_pcb]
2019-11-18 made logic board leave bolt area
    [hardware_4850.kicad_pcb, hardware_4850_logic.kicad_pcb]
2019-11-18 added VCC Diode to LM5008
    [current_filters.sch, hardware_4850.kicad_pcb, interfaces.sch, power_supply.sch]
2019-11-19 Made gerbers ready to order
    [hardware_4850-B_Mask.gbs, hardware_4850-B_SilkS.gbo, hardware_4850-Bottom.gbl, hardware_4850-Edge_Cuts.gm1, hardware_4850-F_Mask.gts, hardware_4850-F_SilkS.gto, hardware_4850-Top.gtl, hardware_4850-job.gbrjob]
2019-11-20 seperated the boards in 2 projects
    [CSS4J-4026.stp, analog.sch, controller.sch, current_filters.sch, enclosure_rnd_455-00370 v1.step, enclosure_rnd_455-00370.stp, enclosure_rnd_455-00370_back.dxf, enclosure_rnd_455-00370_bottom.dxf]
2020-01-21 updated current filters for low current hp
2020-01-25 found the first error SDA and SCL swaped
    [analog.sch, controller.sch, current_filters.sch, hardware_4850.kicad_pcb, hardware_4850.sch, interfaces.sch, power_supply.sch]
2020-02-17 added new filter designs
    [Warenkorb_Feb17_0727.xls]
2020-02-18 added boms
    [hardware_logic_4850_bom.csv, hardware_power_4850_bom.csv]
2020-02-19 created bom with prices
    [BOM.xlsx]
2020-02-26 added voltage filter to the sim
2020-03-06 switched FET and Caps to real values
    [hardware_4850.kicad_pcb, phase.sch]
2020-03-21 second prototype dimensioning
    [analog.sch, current_filters.sch, hardware_4850.kicad_pcb, power_supply.sch]
2020-03-21 parts update
    [hardware_4850.kicad_pcb, interfaces.sch]
2020-04-21 new current filters
    [analog.sch, controller.sch, current_filters.sch, hardware_4850.kicad_pcb, hardware_4850.sch, interfaces.sch, power_supply.sch]
2020-04-24 fixed pwm_en bug
    [hardware_4850.kicad_pcb, interfaces.sch]
2020-05-03 droped ac filters
    [hardware_4850.kicad_pcb]
2020-10-09 coolplate design
    [KühlerUNIMOC10mmAlu.dxf, hardware_4850-Dwgs_User.dxf, hardware_4850-Edge_Cuts.dxf, hardware_4850-Top.dxf, hardware_4850.kicad_pcb]
